Alexander89/cnc-milling-machine/PCB/cnc_rev3.brd

## EAGLE design PCB/cnc_rev3.brd (2020-10-15)

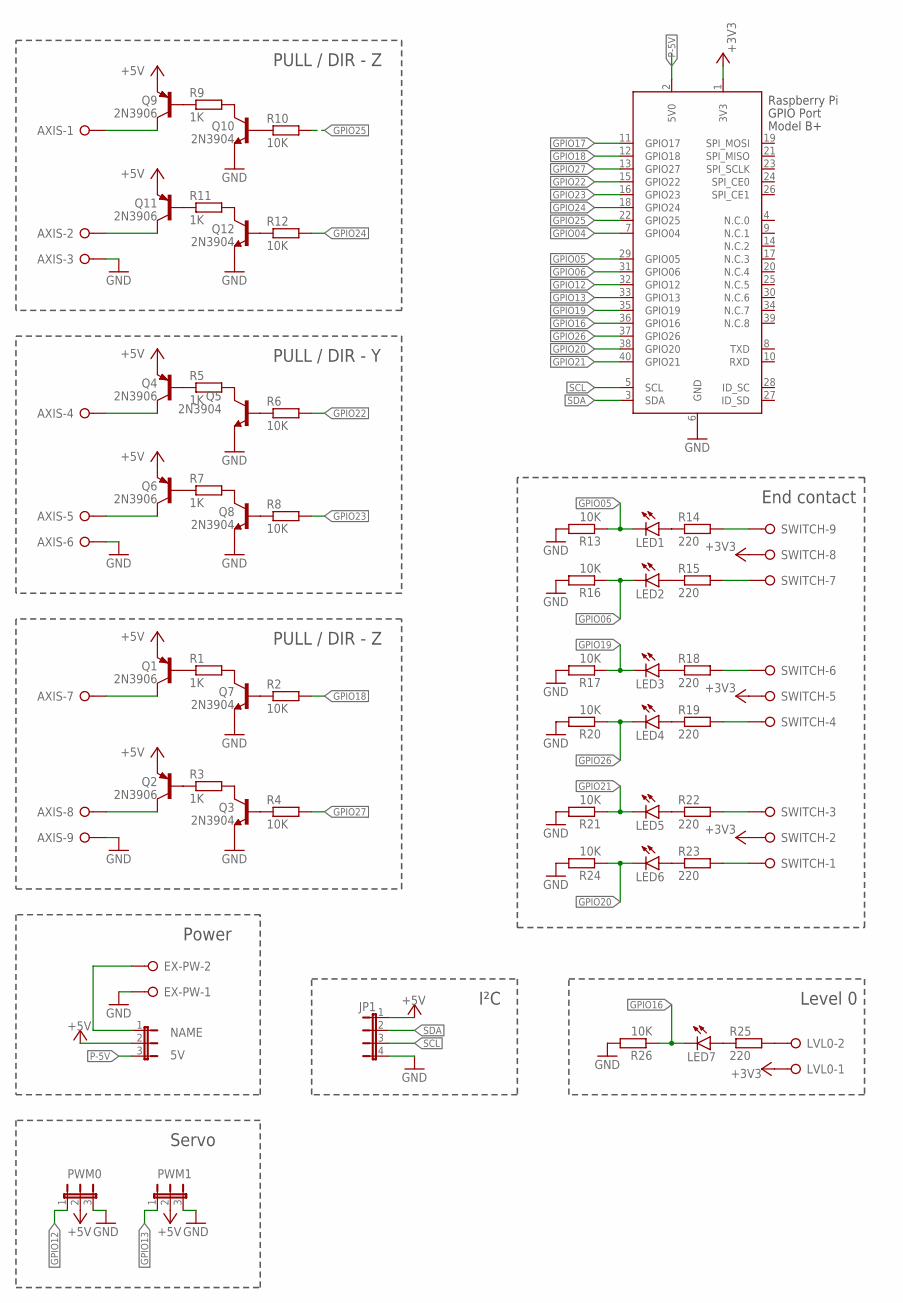
[picture p1: schematic cnc_rev3.sch]

Parts:
AXIS: W237-9P
EX-PW: W237-132
JP1: JP4E; JP4
JP_5V: 5V; JP2
LED1, LED2, LED3, LED4, LED5, LED6: LED3MM
LED7: LED3MM
LVL0: W237-02P; W237-132
PWM0, PWM1: JP2E; JP2
Q1, Q2, Q4, Q6, Q9, Q11: 2N3906; TO92
Q3, Q5, Q7, Q8, Q10, Q12: 2N3904; TO92
R1, R3, R5, R7, R9, R11: 1K; 0414V
R2, R4, R6, R8, R10, R12, R13, R16, R17, R20, R21, R24, R26: 10K; 0414V
R14, R15, R18, R19, R22, R23, R25: 220; 0414V
RPI_CONNECT: RASPI_GPIO_B+_BOX
SWITCH: W237-09P; W237-9P

Connections:
+3V3: LVL0.1, RPI_CONNECT.1 (3V3), SWITCH.2, SWITCH.5, SWITCH.8
+5V: JP1.1, JP_5V.2, PWM0.2, PWM1.2, Q1.3 (E), Q2.3 (E), Q4.3 (E), Q6.3 (E), Q9.3 (E), Q11.3 (E)
DIRU: AXIS.8, Q2.1 (C)
DIRX: AXIS.2, Q11.1 (C)
DIRY: AXIS.5, Q6.1 (C)
GND: AXIS.3, AXIS.6, AXIS.9, EX-PW.1, JP1.4, PWM0.3, PWM1.3, Q3.3 (E), Q5.3 (E), Q7.3 (E), Q8.3 (E), Q10.3 (E), Q12.3 (E), R13.2, R16.2, R17.2, R20.2, R21.2, R24.2, R26.2, RPI_CONNECT.6 (GND)
GPIO04: RPI_CONNECT.7 (GPIO04)
GPIO05: LED1.K (C), R13.1, RPI_CONNECT.29 (GPIO05)
GPIO06: LED2.K (C), R16.1, RPI_CONNECT.31 (GPIO06)
GPIO12: PWM0.1, RPI_CONNECT.32 (GPIO12)
GPIO13: PWM1.1, RPI_CONNECT.33 (GPIO13)
GPIO16: LED7.K (C), R26.1, RPI_CONNECT.36 (GPIO16)
GPIO17: RPI_CONNECT.11 (GPIO17)
GPIO18: R2.2, RPI_CONNECT.12 (GPIO18)
GPIO19: LED3.K (C), R17.1, RPI_CONNECT.35 (GPIO19)
GPIO20: LED6.K (C), R24.1, RPI_CONNECT.38 (GPIO20)
GPIO21: LED5.K (C), R21.1, RPI_CONNECT.40 (GPIO21)
GPIO22: R6.2, RPI_CONNECT.15 (GPIO22)
GPIO23: R8.2, RPI_CONNECT.16 (GPIO23)
GPIO24: R12.2, RPI_CONNECT.18 (GPIO24)
GPIO25: R10.2, RPI_CONNECT.22 (GPIO25)
GPIO26: LED4.K (C), R20.1, RPI_CONNECT.37 (GPIO26)
GPIO27: R4.2, RPI_CONNECT.13 (GPIO27)
unnamed: Q1.2 (B), R1.1
unnamed: Q7.1 (C), R1.2
unnamed: Q7.2 (B), R2.1
unnamed: LED7.A, R25.1
unnamed: LVL0.2, R25.2
unnamed: Q4.2 (B), R5.1
unnamed: LED1.A, R14.1
unnamed: Q2.2 (B), R3.1
unnamed: Q3.2 (B), R4.1
unnamed: Q3.1 (C), R3.2
unnamed: Q5.2 (B), R6.1
unnamed: Q5.1 (C), R5.2
unnamed: Q6.2 (B), R7.1
unnamed: Q8.2 (B), R8.1
unnamed: Q8.1 (C), R7.2
unnamed: Q9.2 (B), R9.1
unnamed: Q10.2 (B), R10.1
unnamed: Q10.1 (C), R9.2
unnamed: Q11.2 (B), R11.1
unnamed: Q12.2 (B), R12.1
unnamed: Q12.1 (C), R11.2
unnamed: R14.2, SWITCH.9
unnamed: LED2.A, R15.1
unnamed: R15.2, SWITCH.7
unnamed: LED3.A, R18.1
unnamed: R18.2, SWITCH.6
unnamed: LED4.A, R19.1
unnamed: R19.2, SWITCH.4
unnamed: LED5.A, R22.1
unnamed: R22.2, SWITCH.3
unnamed: LED6.A, R23.1
unnamed: R23.2, SWITCH.1
P-5V: JP_5V.3, RPI_CONNECT.2 (5V0)
P-EXT: EX-PW.2, JP_5V.1
PULU: AXIS.7, Q1.1 (C)
PULY: AXIS.4, Q4.1 (C)
PULZ: AXIS.1, Q9.1 (C)
SCL: JP1.3, RPI_CONNECT.5 (SCL)
SDA: JP1.2, RPI_CONNECT.3 (SDA)

Notes on the sheet:
Level 0
I²C
End contact
Power
Servo
PULL / DIR - Z
PULL / DIR - Y

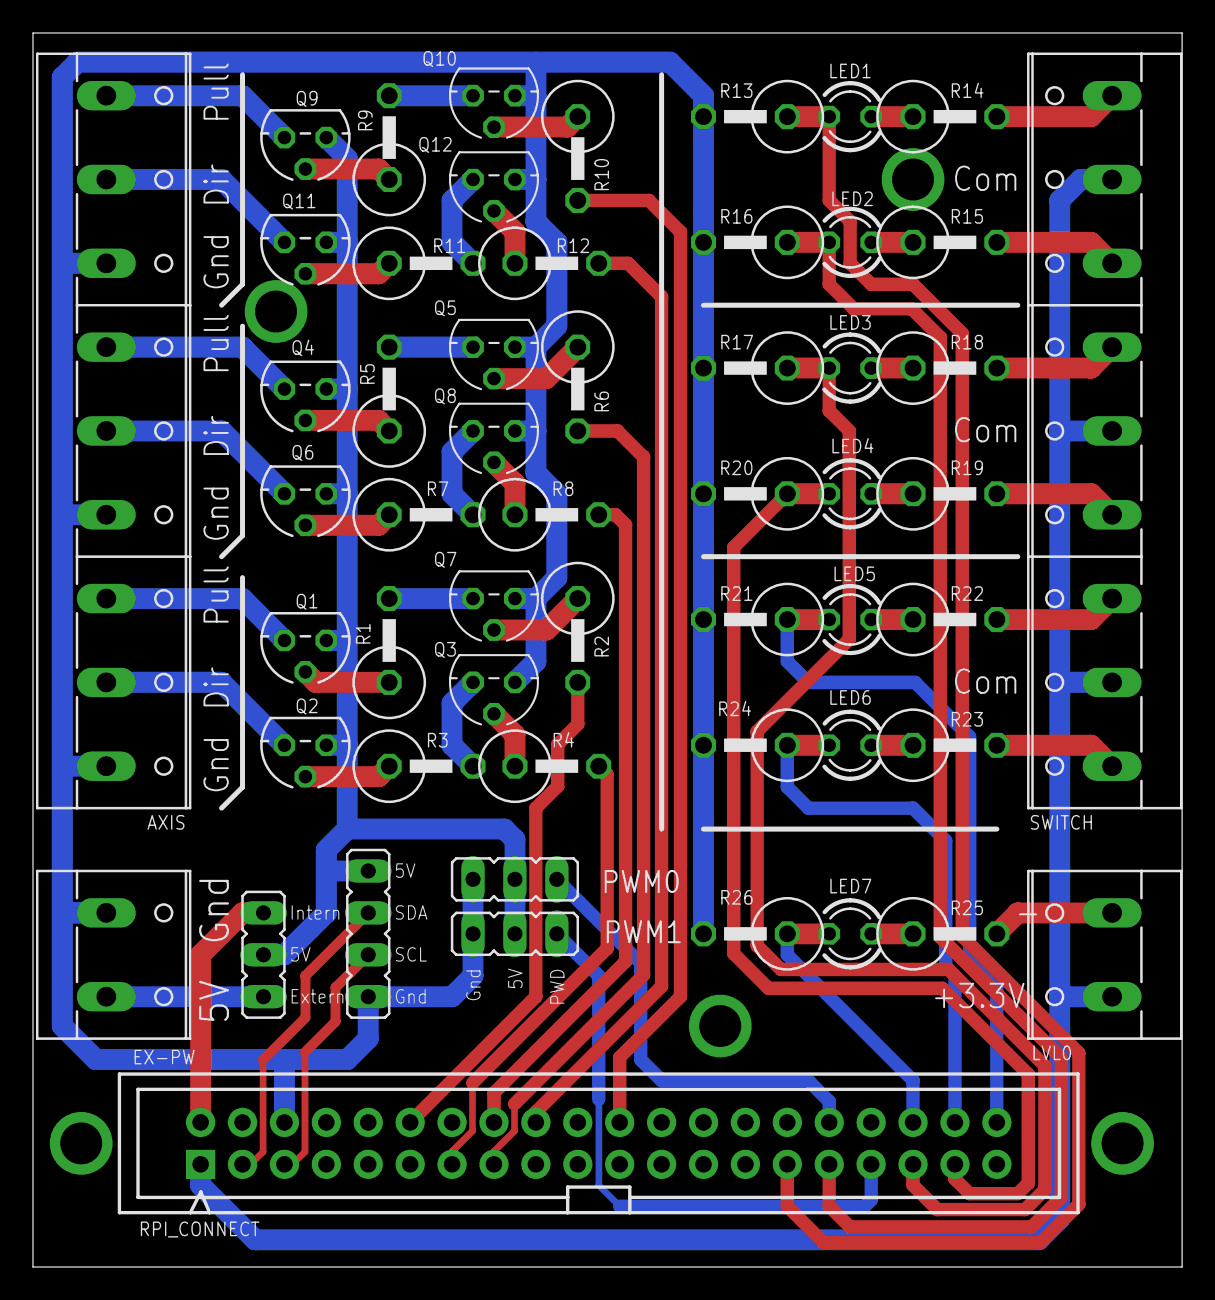
[picture p2: board cnc_rev3.brd from above]

Board: 2 copper layers, 69.6 x 74.8 mm, 54 parts (0 on the bottom side), 60 nets.
