Alexander89/cnc-milling-machine/(commit log)

2020-07-05 Low lvl motor driver
2020-07-25 stepsize per motor
2020-08-15 add calibration
2020-09-06 invert - z function
    [mod.rs]
2020-09-11 calibrated + reset
2020-10-15 fix speed for programs
    [mod.rs]
2020-10-15 add Eagle files
    [cnc_rev3.brd, cnc_rev3.sch]
2020-10-15 first draft for motor ramp
2021-01-12 more UI stuff (redesign, settings)
    [settings.rs, types.rs, ws_connection.rs]
2021-01-20 refactor project / motor mod
2021-01-20 fix save and more refactoring
    [mod.rs, run.rs, ui_communication.rs]
2021-01-20 fix save in ui
    [ui_communication.rs]
2021-01-21 move On_off switch to controller_thread add settings, add on_off_delay settings connect to Miscellaneous commands in programs add on_off to UI
2021-01-23 fit to mobile devices
2021-01-23 fix output + clean up
    [actor.rs, mod.rs, motor_controller.rs, motor_controller_thread.rs, run.rs, step_motor.rs, switch.rs]
2021-01-25 interchange endswitch when dir invert
    [step_motor.rs]
2021-02-20 change to mm/min (pref mm/sec), calibrate (min, max, middle), compensate overshooting after motor ramp-up, cleanup
    [mock_motor.rs, mod.rs, motor_controller_thread.rs, run.rs, settings.rs, step_motor.rs, task.rs, types.rs]
